ccwtruck/LinuxCNC-4x4-PlasmaTable/README.md

# LinuxCNC-4x4-PlasmaTable
Complete working LinuxCNC 54" x 60" Plasma Table Control Software With Arduino Mega 2560 THC <br>
<br>
This is a complete working machine configuration for the 54" x 60" CNC plasma table I built in EMC2 (LinuxCNC). <br>
<br>
The specifications for the physical table & controller electronics are: <br>
<br>
<ul>
	<li>Computer</li><br>
		<ul>
			<li>Dell Optiplex 755 (or other antique PC with a parallel port & open PCIe slot) </li><br>
			<li>Vantec 1-Port Parallel PCIe Host Card (UGT-PCE10PL)  </li><br>
			<li>(2) 25 Foot DB25 25 Pin Serial Port Cables, Male/Female </li><br>
		</ul>
	<li>Cabinet Electronics </li><br>
		<ul>
			<li>(2) SainSmart ST-v3 Parallel Break-Out Boards </li><br>
			<li>(3) RattmMotor Model DMA-860-S Stepper Motor Controllers (X, Y, YTandem Axis) </li><br>
			<li>(1) MakerBase MKS TMC2160-OC Stepper Motor Driver (Z-Axis) </li><br>
			<li>(1) 24 volt 8-input Opto-isolated Relay Board  </li><br>
			<li>(8) Taiss LJ12A3-4-Z/AX Proximity Switch Inductive Proximity Sensors  </li><br>
			<li>(1) 5 volt Switching Power Supply </li><br>
			<li>(1) 24 volt Switching Power Supply </li><br>
			<li>(1) Arduino Mega 2560 R3 Development Board (THC) </li><br>
			<li>(1) Nextion Enhanced 3.5 inch HMI Display Resistive Touch Screen 5V TFT LCD 480x320 </li><br>
			<li>(1) 9 volt Arduino-compatible "Wall Wart" Power Adapter </li><br>
		</ul>
	<li>Mechanical Components</li><br>
		<ul>
			<li>(1) RATTMMOTOR EBX1605 100mm / 3.94" CNC Linear Stage Actuator (Z-Axis) </li><br>
			<li>(3) STEPPERONLINE High Torque Nema 23 CNC Stepper Motors, 114mm 425oz.in/3Nm </li><br>
			<li>(2) SFU1605 ballscrews 16mm 1500mm (Y & YTandem Axis) </li><br>
			<li>(1) SFU1605 ballscrew 16mm 1550mm (X Axis) </li><br>
			<li>(3) Motor Mounting Brackets and BK12 Bearing End Support Blocks for Nema 23 Stepper Motor and Ball Screw 16mm </li><br>
			<li>(1) Electrical Box 23.6'' x 20'' x 8'' Indoor/Outdoor </li><br>
		</ul>
	</ul>
</ul>
Stainsmart_Breakout_ST-V3_Board
