ccwtruck/LinuxCNC-4x4-PlasmaTable/Stainsmart_Breakout_ST-V3_Board 2.jpg

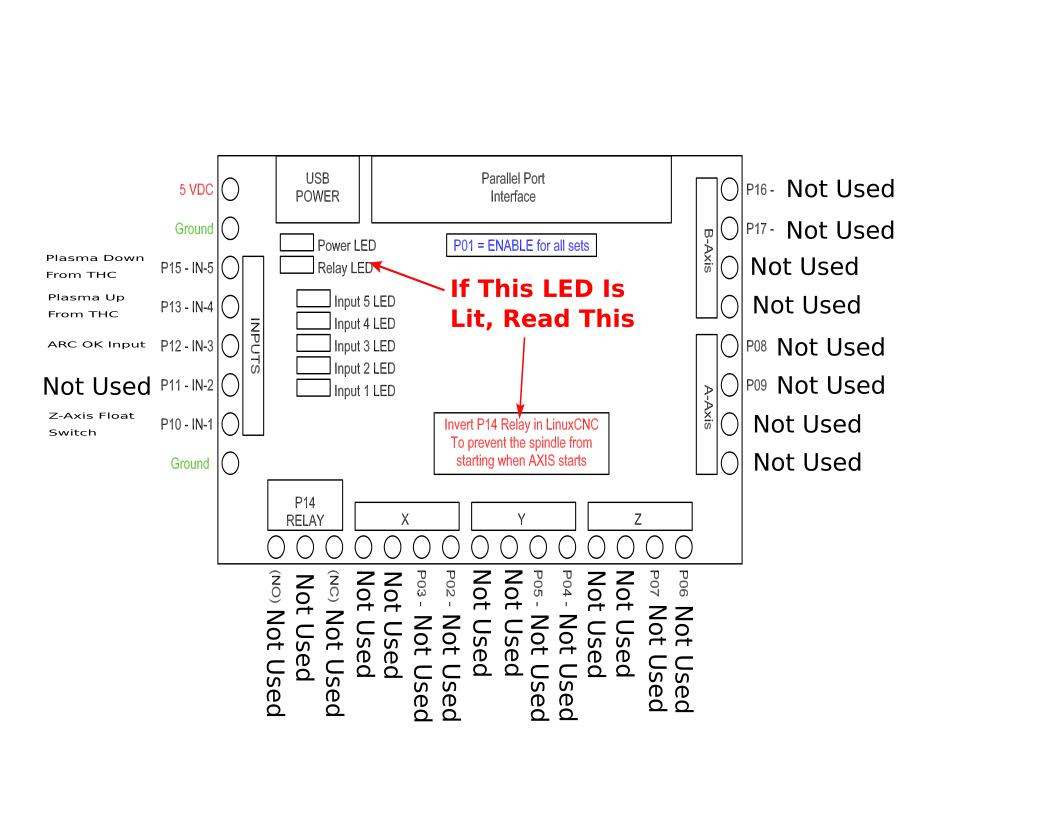
Stainsmart_Breakout_ST-V3_Board 2.jpg
