ccwtruck/LinuxCNC-4x4-PlasmaTable/LinuxCNC-Backup-main/Plasma-THC/Plasma-THC.hal

# Generated by stepconf 1.1 at Tue Jul 23 21:51:38 2024
# If you make changes to this file, they will be
# overwritten when you run stepconf again
loadrt [KINS]KINEMATICS
loadrt [EMCMOT]EMCMOT base_period_nsec=[EMCMOT]BASE_PERIOD servo_period_nsec=[EMCMOT]SERVO_PERIOD num_joints=[KINS]JOINTS num_spindles=[TRAJ]SPINDLES
loadrt hal_parport cfg="0x378 out 0xdcf0 out"
setp parport.0.reset-time 2000
loadrt stepgen step_type=0,0,0,0
loadrt lut5
loadrt  plasmac

#================================================================
# Implementation of light mast. Requires adding two LED's
# Load classic ladder
#loadrt classicladder_rt numPhysInputs=15 numPhysOutputs=15 numS32in=10 numS32out=10 numFloatIn=10 numFloatOut=10 numBits=50 numWords=50
#addf classicladder.0.refresh servo-thread
#loadusr classicladder --nogui custom.clp
#loadusr classicladder custom.clp
# End light mast implementation
#================================================================

addf parport.0.read base-thread
addf parport.1.read base-thread
addf stepgen.make-pulses base-thread
addf parport.0.write base-thread
addf parport.0.reset base-thread
addf parport.1.write base-thread

addf stepgen.capture-position servo-thread
addf motion-command-handler servo-thread
addf motion-controller servo-thread
addf plasmac servo-thread
addf stepgen.update-freq servo-thread
addf lut5.0 servo-thread

# ---PLASMA INPUT DEBOUNCE---
loadrt dbounce names=db_breakaway,db_float,db_ohmic,db_arc-ok
addf db_float     servo-thread
addf db_ohmic     servo-thread
addf db_breakaway servo-thread
addf db_arc-ok    servo-thread

setp parport.0.pin-14-out-invert TRUE
setp parport.1.pin-14-out-invert TRUE

# ---JOINT ASSOCIATED WITH THE Z AXIS---
net plasmac:axis-position joint.3.pos-fb => plasmac.axis-z-position

# ---PLASMA INPUTS---
# ---all modes---
net plasmac:float-switch   => db_float.in
#net plasmac:breakaway      => db_breakaway.in
#net plasmac:ohmic-probe    => db_ohmic.in
#net plasmac:ohmic-sense-in   => plasmac.ohmic-sense-in
# ---modes 0 & 1
#net plasmac:arc-voltage-in => plasmac.arc-voltage-in
# ---modes 1 & 2
net plasmac:arc-ok-in      => db_arc-ok.in
# ---mode 2
net plasmac:move-up        => plasmac.move-up
net plasmac:move-down      => plasmac.move-down

# ---PLASMA OUTPUTS---
# ---all modes---
#net plasmac:ohmic-enable   <= plasmac.ohmic-enable
#net plasmac:scribe-arm     <= plasmac.scribe-arm
#net plasmac:scribe-on      <= plasmac.scribe-on

net estop-out       => parport.0.pin-01-out
net xstep           => parport.0.pin-02-out
setp parport.0.pin-02-out-reset 1
net xdir            => parport.0.pin-03-out
net ystep           => parport.0.pin-04-out
setp parport.0.pin-04-out-reset 1
net ydir            => parport.0.pin-05-out
net zstep           => parport.0.pin-06-out
setp parport.0.pin-06-out-reset 1
net zdir            => parport.0.pin-07-out
net y2step          => parport.0.pin-08-out
setp parport.0.pin-08-out-reset 1
net y2dir           => parport.0.pin-09-out

net plasmac:torch-on => parport.0.pin-14-out

net estop-ext       <= parport.0.pin-13-in

net both-home-y2    <= parport.0.pin-10-in-not
net both-home-x     <= parport.0.pin-11-in-not
net both-home-y     <= parport.0.pin-12-in-not
net estop-ext       <= parport.0.pin-13-in
net both-home-z     <= parport.0.pin-15-in-not

net plasmac:float-switch <= parport.1.pin-10-in-not
net plasmac:arc-ok-in <= parport.1.pin-12-in
net plasmac:move-up <= parport.1.pin-13-in
net plasmac:move-down <= parport.1.pin-15-in

setp lut5.0.function 0x10000
net all-limit-home => lut5.0.in-4
net all-limit <= lut5.0.out
net xhoming <= joint.0.homing => lut5.0.in-0
net yhoming <= joint.1.homing => lut5.0.in-1
net y2homing <= joint.2.homing => lut5.0.in-2
net zhoming <= joint.3.homing => lut5.0.in-3

setp stepgen.0.position-scale [JOINT_0]SCALE
setp stepgen.0.steplen 1
setp stepgen.0.stepspace 0
setp stepgen.0.dirhold 109217
setp stepgen.0.dirsetup 109217
setp stepgen.0.maxaccel [JOINT_0]STEPGEN_MAXACCEL
net xpos-cmd joint.0.motor-pos-cmd => stepgen.0.position-cmd
net xpos-fb stepgen.0.position-fb => joint.0.motor-pos-fb
net xstep <= stepgen.0.step
net xdir <= stepgen.0.dir
net xenable joint.0.amp-enable-out => stepgen.0.enable
net both-home-x => joint.0.home-sw-in
net both-home-x => joint.0.neg-lim-sw-in
net both-home-x => joint.0.pos-lim-sw-in

setp stepgen.1.position-scale [JOINT_1]SCALE
setp stepgen.1.steplen 1
setp stepgen.1.stepspace 0
setp stepgen.1.dirhold 109217
setp stepgen.1.dirsetup 109217
setp stepgen.1.maxaccel [JOINT_1]STEPGEN_MAXACCEL
net ypos-cmd joint.1.motor-pos-cmd => stepgen.1.position-cmd
net ypos-fb stepgen.1.position-fb => joint.1.motor-pos-fb
net ystep <= stepgen.1.step
net ydir <= stepgen.1.dir
net yenable joint.1.amp-enable-out => stepgen.1.enable
net both-home-y => joint.1.home-sw-in
net both-home-y => joint.1.neg-lim-sw-in
net both-home-y => joint.1.pos-lim-sw-in

setp stepgen.2.position-scale [JOINT_2]SCALE
setp stepgen.2.steplen 1
setp stepgen.2.stepspace 0
setp stepgen.2.dirhold 109217
setp stepgen.2.dirsetup 109217
setp stepgen.2.maxaccel [JOINT_2]STEPGEN_MAXACCEL
net y2pos-cmd joint.2.motor-pos-cmd => stepgen.2.position-cmd
net y2pos-fb stepgen.2.position-fb => joint.2.motor-pos-fb
net y2step <= stepgen.2.step
net y2dir <= stepgen.2.dir
net y2enable joint.2.amp-enable-out => stepgen.2.enable
net both-home-y2 => joint.2.home-sw-in
net both-home-y2 => joint.2.neg-lim-sw-in
net both-home-y2 => joint.2.pos-lim-sw-in

setp stepgen.3.position-scale [JOINT_3]SCALE
setp stepgen.3.steplen 1
setp stepgen.3.stepspace 0
setp stepgen.3.dirhold 109217
setp stepgen.3.dirsetup 109217
setp stepgen.3.maxaccel [JOINT_3]STEPGEN_MAXACCEL
net zpos-cmd joint.3.motor-pos-cmd => stepgen.3.position-cmd
net zpos-fb stepgen.3.position-fb => joint.3.motor-pos-fb
net zstep <= stepgen.3.step
net zdir <= stepgen.3.dir
net zenable joint.3.amp-enable-out => stepgen.3.enable
net both-home-z => joint.3.home-sw-in
net both-home-z => joint.3.neg-lim-sw-in
net both-home-z => joint.3.pos-lim-sw-in

net estop-out <= iocontrol.0.user-enable-out
net estop-ext => iocontrol.0.emc-enable-in

net tool-number <= iocontrol.0.tool-prep-number
net tool-change-loopback iocontrol.0.tool-change => iocontrol.0.tool-changed
net tool-prepare-loopback iocontrol.0.tool-prepare => iocontrol.0.tool-prepared
