ccwtruck/LinuxCNC-4x4-PlasmaTable/LinuxCNC-Backup-main/Plasma-THC/Plasma-THC_material.cfg

[MATERIAL_NUMBER_0]
NAME = Basic default Material
KERF_WIDTH = 1.0
PIERCE_HEIGHT = 3.0
PIERCE_DELAY = 0.1
PUDDLE_JUMP_HEIGHT = 0.0
PUDDLE_JUMP_DELAY = 0.0
CUT_HEIGHT = 1.0
CUT_SPEED = 1000.0
CUT_AMPS = 45.0
CUT_VOLTS = 100.0
PAUSE_AT_END = 0.0
GAS_PRESSURE = 0.0
CUT_MODE = 1.0

[MATERIAL_NUMBER_1]
NAME = 1/2 in Mild Steel
KERF_WIDTH = 1.2
PIERCE_HEIGHT = 6.0
PIERCE_DELAY = 3.2
PUDDLE_JUMP_HEIGHT = 1.0
PUDDLE_JUMP_DELAY = 0.0
CUT_HEIGHT = 3.2
CUT_SPEED = 450.0
CUT_AMPS = 80.0
CUT_VOLTS = 120.0
PAUSE_AT_END = 0.0
GAS_PRESSURE = 0.0
CUT_MODE = 1.0
