ccwtruck/LinuxCNC-4x4-PlasmaTable/LinuxCNC-Backup-main/Plasma-THC/Plasma-THC.ini

# Generated by stepconf 1.1 at Tue Jul 23 21:51:38 2024
# If you make changes to this file, they will be
# overwritten when you run stepconf again

[EMC]
MACHINE = Plasma-THC
DEBUG = 0
VERSION = 1.1

[DISPLAY]
DISPLAY = qtvcp qtplasmac
POSITION_OFFSET = RELATIVE
POSITION_FEEDBACK = ACTUAL
ARCDIVISION = 64
GRIDS = 10mm 20mm 50mm 100mm 1in 2in 5in 10in
MAX_FEED_OVERRIDE = 1.2
DEFAULT_LINEAR_VELOCITY = 2.69
MIN_LINEAR_VELOCITY = 0
MAX_LINEAR_VELOCITY = 26.89
CYCLE_TIME = 0.100
INTRO_GRAPHIC = linuxcnc.gif
INTRO_TIME = 5
PROGRAM_PREFIX = /home/john/linuxcnc/nc_files
INCREMENTS = 10mm 1mm .1mm .01mm .001mm

[KINS]
JOINTS = 4
KINEMATICS = trivkins coordinates=XYYZ

[FILTER]
PROGRAM_EXTENSION = .ngc,.nc,.tap GCode File (*.ngc, *.nc, *.tap)
ngc = qtplasmac_gcode
nc  = qtplasmac_gcode
tap = qtplasmac_gcode

[TASK]
TASK = milltask
CYCLE_TIME = 0.010

[RS274NGC]
PARAMETER_FILE = linuxcnc.var
RS274NGC_STARTUP_CODE = G21 G40 G49 G80 G90 G92.1 G94 G97 M52P1
SUBROUTINE_PATH = ./:../../nc_files
USER_M_PATH = ./:../../nc_files


[EMCMOT]
EMCMOT = motmod
COMM_TIMEOUT = 1.0
BASE_PERIOD = 116217
SERVO_PERIOD = 1000000

[HAL]
HALUI = halui
HALFILE = Plasma-THC.hal
HALFILE = qtplasmac_comp.hal
HALFILE = custom.hal
POSTGUI_HALFILE = custom_postgui.hal
SHUTDOWN = shutdown.hal

[TRAJ]
SPINDLES = 3
COORDINATES =  X Y Y Z
LINEAR_UNITS = mm
ANGULAR_UNITS = degree
DEFAULT_LINEAR_VELOCITY = 2.69
MAX_LINEAR_VELOCITY = 26.89

[EMCIO]
EMCIO = io
CYCLE_TIME = 0.100
TOOL_TABLE = tool.tbl

#*** AXIS_X *******************************
[AXIS_X]
# MAX_VEL & MAX_ACC need to be twice the corresponding joint value
MAX_VELOCITY = 51.08977172014421
MAX_ACCELERATION = 2000.0
OFFSET_AV_RATIO = 0.5
MIN_LIMIT = -5.0
MAX_LIMIT = 1400.0

[JOINT_0]
TYPE = LINEAR
HOME = 0.0
MIN_LIMIT = -5.0
MAX_LIMIT = 1400.0
MAX_VELOCITY = 25.544885860072107
MAX_ACCELERATION = 1000.0
STEPGEN_MAXACCEL = 1250.0
SCALE = 320.0
FERROR = 1
MIN_FERROR = .25
HOME_OFFSET = -8.000000
HOME_SEARCH_VEL = -12.500000
HOME_LATCH_VEL = -1.562500
HOME_IGNORE_LIMITS = YES
HOME_SEQUENCE = 1
#******************************************

#*** AXIS_Y *******************************
[AXIS_Y]
# MAX_VEL & MAX_ACC need to be twice the corresponding joint value
MAX_VELOCITY = 51.08977172014421
MAX_ACCELERATION = 2000.0
OFFSET_AV_RATIO = 0.5
MIN_LIMIT = -5.0
MAX_LIMIT = 1400.0

[JOINT_1]
TYPE = LINEAR
HOME = 0.0
MIN_LIMIT = -5.0
MAX_LIMIT = 1400.0
MAX_VELOCITY = 25.544885860072107
MAX_ACCELERATION = 1000.0
STEPGEN_MAXACCEL = 1250.0
SCALE = -320.0
FERROR = 1
MIN_FERROR = .25
HOME_OFFSET = -5.000000
HOME_SEARCH_VEL = -12.500000
HOME_LATCH_VEL = -1.562500
HOME_IGNORE_LIMITS = YES
HOME_SEQUENCE = -2

[JOINT_2]
TYPE = LINEAR
HOME = 0.0
MIN_LIMIT = -5.0
MAX_LIMIT = 1400.0
MAX_VELOCITY = 25.544885860072107
MAX_ACCELERATION = 1000.0
STEPGEN_MAXACCEL = 1250.0
SCALE = -320.0
FERROR = 1
MIN_FERROR = .25
HOME_OFFSET = -5.000000
HOME_SEARCH_VEL = -12.500000
HOME_LATCH_VEL = -1.562500
HOME_IGNORE_LIMITS = YES
HOME_SEQUENCE = -2
#******************************************

#*** AXIS_Z *******************************
[AXIS_Z]
# MAX_VEL & MAX_ACC need to be twice the corresponding joint value
MAX_VELOCITY = 51.08977172014421
MAX_ACCELERATION = 2000.0
OFFSET_AV_RATIO = 0.5
MIN_LIMIT = -125.0
MAX_LIMIT = 5.0

[JOINT_3]
TYPE = LINEAR
HOME = 0.0
MIN_LIMIT = -125.0
MAX_LIMIT = 5.0
MAX_VELOCITY = 25.544885860072107
MAX_ACCELERATION = 1000.0
STEPGEN_MAXACCEL = 1250.0
SCALE = 320.0
FERROR = 1
MIN_FERROR = .25
HOME_OFFSET = 5.000000
HOME_SEARCH_VEL = 10.500000
HOME_LATCH_VEL = 1.500000
HOME_IGNORE_LIMITS = YES
HOME_SEQUENCE = 0
#******************************************
