ccwtruck/LinuxCNC-4x4-PlasmaTable/(commit log)

2024-07-28 SainSmart ST-v3 Wiring Pin Out
2024-07-28 Board 2 Wiring Pin Out Diagram
